argenthand/kabuki-keyboard/fit/kabuki_left_fit_plate_mx_14.0.stl

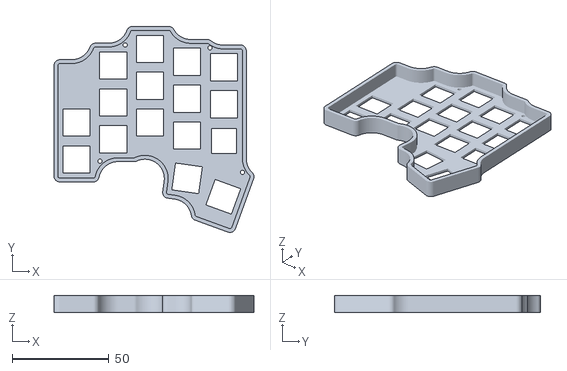
[picture p1: CAD file, 2026-11-11]
fit/kabuki_left_fit_plate_mx_14.0.stl
103.2 x 106.3 x 9.00
