argenthand/kabuki-keyboard/(list of files, cad)

Other CAD files:
fit/kabuki_right_fit_plate_mx_14.0.stl
