argenthand/kabuki-keyboard/pcb/left/left.kicad_pcb

## KiCad design pcb/left/left.kicad_pcb (2026-11-11)

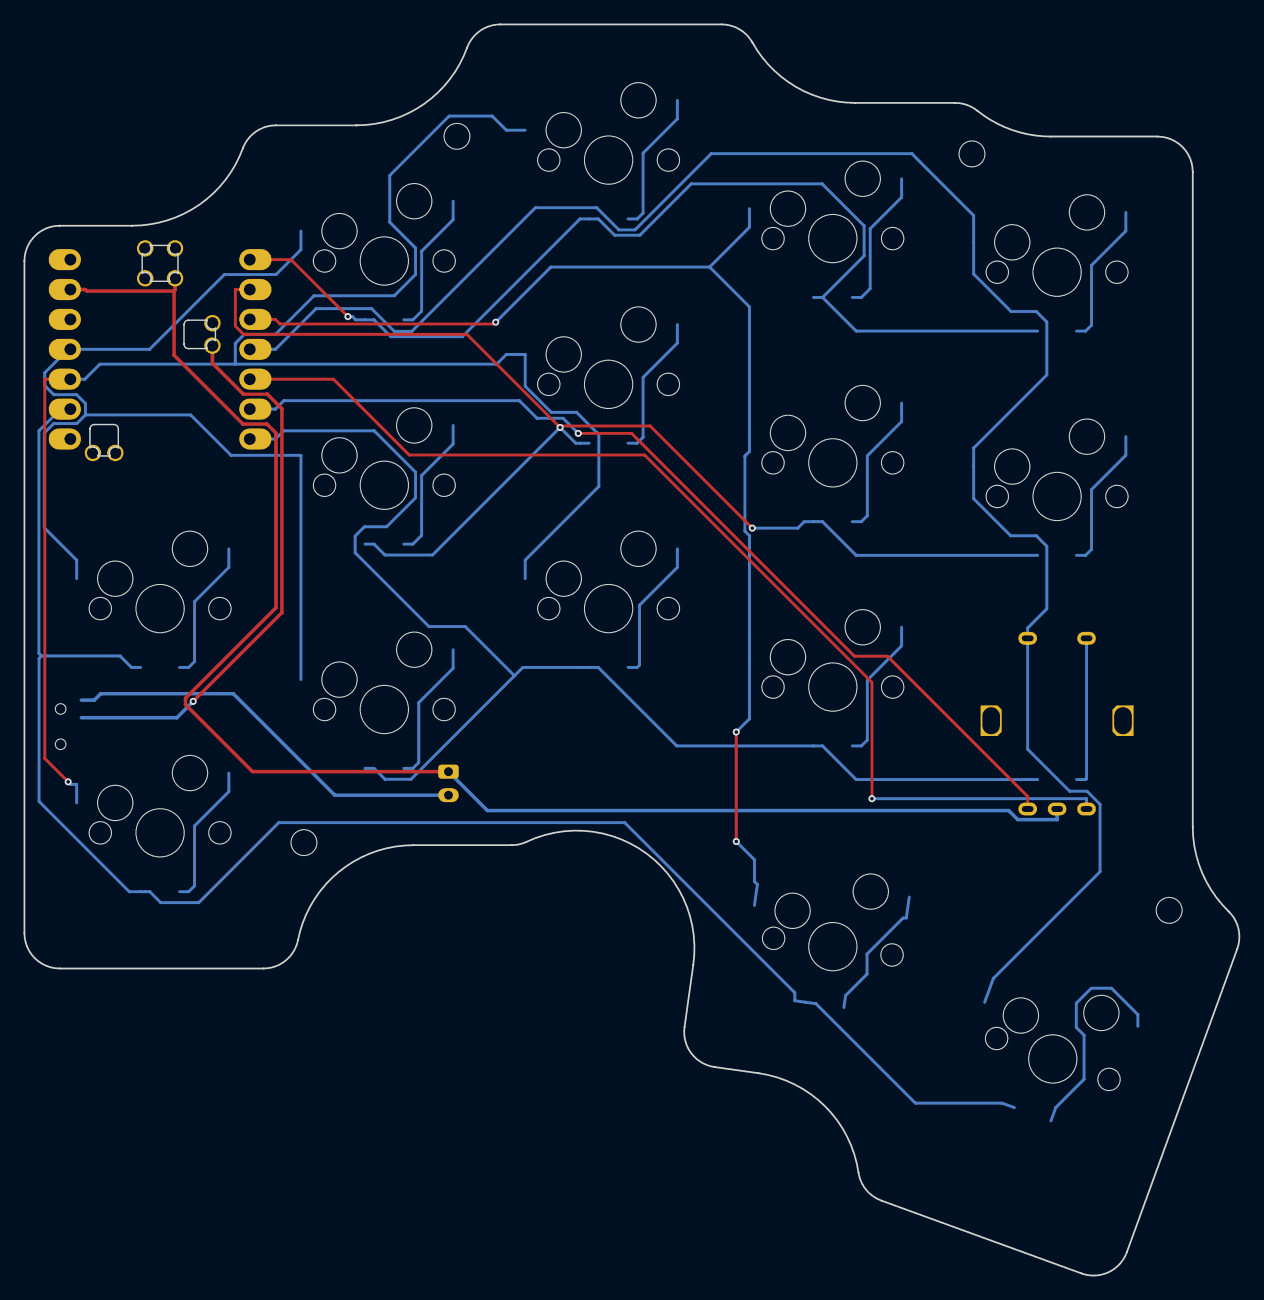
[picture p2: board left.kicad_pcb from above]

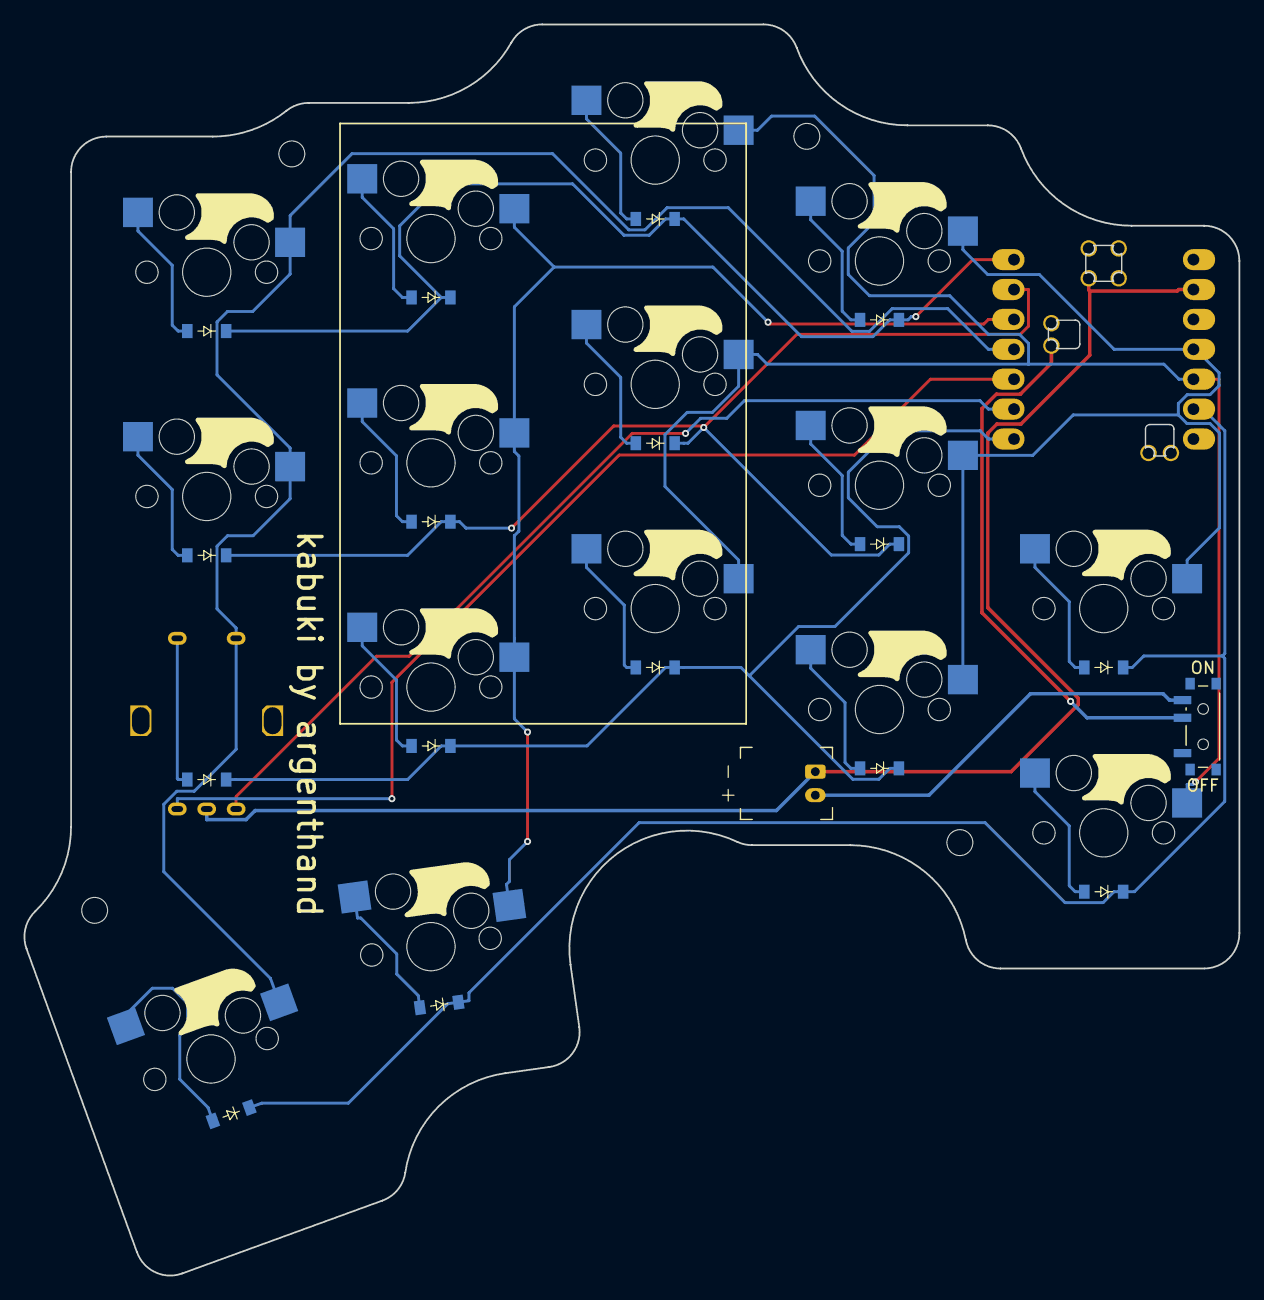
[picture p3: board left.kicad_pcb from below]

Board: 2 copper layers, 103.2 x 106.3 mm, 39 parts (34 on the bottom side), 29 nets.

Parts:
D1, D2, D3, D4, D5, D6, D7, D8, D9, D10, D11, D12, D13, D14, D15, D16: diode_tht_sod123
JST1: battery_connector_jst_ph_2
MCU1: XIAO-BLE
MH1, MH2, MH3, MH4: mounting_hole_npth
PWR1: power_switch_smd_side
RE1: rotary_encoder_ec11_ec12
S1, S2, S3, S4, S5, S6, S7, S8, S9, S10, S11, S12, S13, S14, S15: switch_mx

Connections:
BAT_P: JST1.2, PWR1.3
BAT_SW: MCU1.19, PWR1.2
C0: MCU1.11, S2.1, S3.1, S4.1, S5.1
C1: MCU1.10, S1.1, S6.1, S7.1, S8.1
C2: MCU1.3, S9.1, S10.1, S11.1, S14.1
C3: MCU1.4, RE1.S1, S12.1, S13.1, S15.1
ENC_A: MCU1.5, RE1.A
ENC_B: MCU1.6, RE1.C
GND: JST1.1, MCU1.13, MCU1.17, RE1.B
R0: D5.1, D8.1, D11.1, D14.1, MCU1.1
R1: D4.1, D7.1, D10.1, D13.1, MCU1.2
R2: D3.1, D6.1, D9.1, D12.1, MCU1.7
R3: D1.1, D2.1, D15.1, D16.1, MCU1.9
far_thumb: D16.2, S15.2
index_bottom: D9.2, S9.2
index_home: D10.2, S10.2
index_top: D11.2, S11.2
inner_bottom: D12.2, RE1.S2
inner_home: D13.2, S12.2
inner_top: D14.2, S13.2
middle_bottom: D6.2, S6.2
middle_home: D7.2, S7.2
middle_top: D8.2, S8.2
near_thumb: D15.2, S14.2
pinky_bottom: D1.2, S1.2
pinky_home: D2.2, S2.2
ring_bottom: D3.2, S3.2
ring_home: D4.2, S4.2
ring_top: D5.2, S5.2
