argenthand/kabuki-keyboard/(commit log)

2026-11-06 Ignore correct PCB output directory
2026-11-09 Hybrid MX + Choc switches
2026-11-10 v0: first routing pass on the left half
    Final v0 state (trackpoint design, hybrid MX + Choc sockets) before the v1 reset.
    Claude-Session: https://claude.ai/code/session_018DjbWUgJxFZRYbZiot2pPy
    [left.kicad_pcb, right.kicad_pcb]
2026-11-10 Re-scope and simplify the project for v1
    [kabuki_left_fit_plate_mx_14.0.stl, kabuki_right_fit_plate_mx_14.0.stl, left.kicad_pcb, right.kicad_pcb]
2026-11-11 Add text to PCB
    [kabuki_left_fit_plate_mx_14.0.stl, kabuki_right_fit_plate_mx_14.0.stl, left.kicad_pcb, right.kicad_pcb]
